Zrh0116/owlbot_main/wiring_diagramv2_bb.jpg

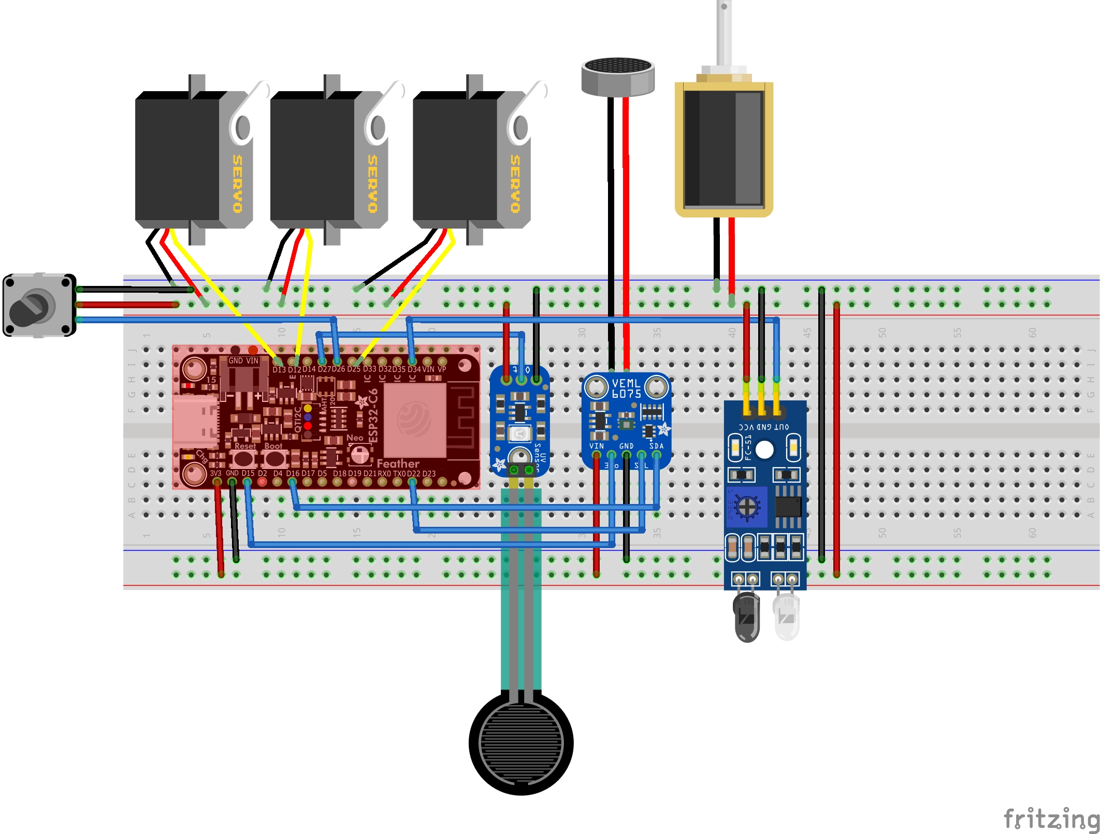
wiring_diagramv2_bb.jpg
